luscasos/PI3-carro/Hardware/3d placa.png

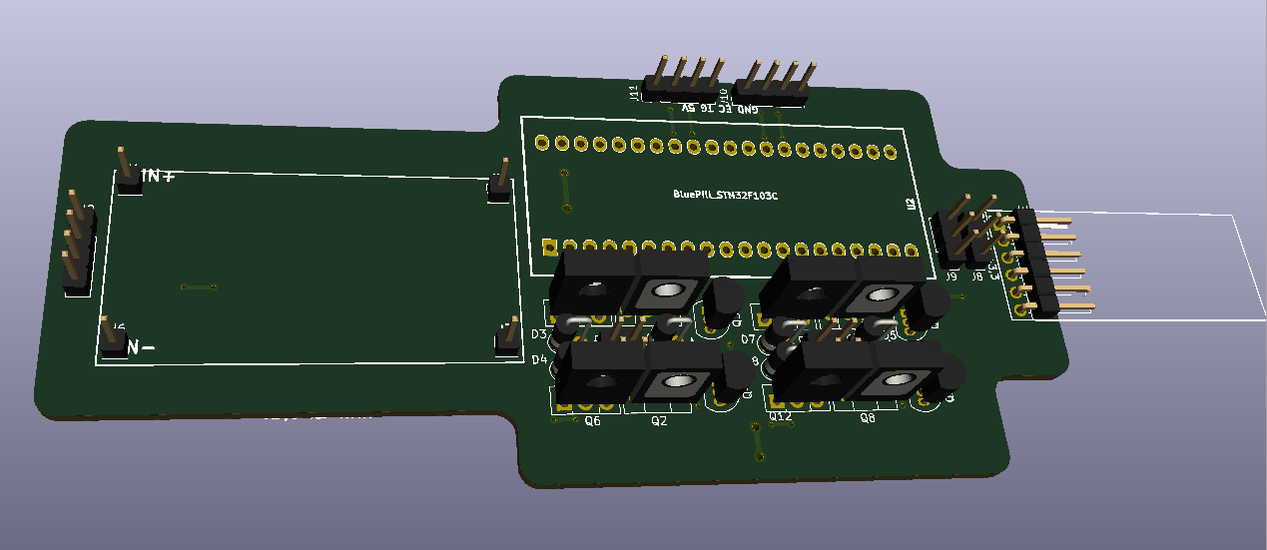
Hardware/3d placa.png
