luscasos/PI3-carro/README.md

# Projeto integrador III

carro final

## Informações gerais
Desenvolvido no escopo da disciplina de Projeto Integrador III, do curso de Eng. Eletrônica do IFSC campus Florianópolis no primeiro semestre de 2019, esse projeto tem como objetivo utilizar os conhecimentos obtidos ao decorrer do curso, implementando um carro controlado via aplicativo Android.

## Tabela inicial de requisitos
* Controle via aplicativo Android
* Comunicação via bluetooth
* Sensoriamento de velocidade e transmissão para o app 
* Controle de velocidade via aplicativo 
* Controle da bateria

## Tecnologias
* Parte mecânica do carro, disponível em https://s.click.aliexpress.com/e/bD9t0zL3
* Celular Android
* Microcontrolador STM32
* Bateria de íon de lítio
	
# Hardware

* ## Acionamento dos motores

Para acionar os motores foram levadas em conta os requisitos de projeto, que nesse quesito são:
* Controle de direção do movimento
* Controle de velocidade

Com relação ao controle de direção foi escolhido o sistema de ponte H, na qual é possível alterar o sentido da corrente invertendo as tensões nos terminais L e R, a forma escolhida de acionamento dos motores foi conectar em paralelo os motores do mesmo lado do carro, necessitando de duas pontes para o controle dos quatro motores 

Ponte H

O primeiro filtro para escolha do circuito foi a disponibilidade de componentes no almoxarifado, que para ponte H se limitava a:
* L293B
Corrente máxima 1A por canal

* L6203		
Corrente máxima 5A

* SN754410NE
Com uso restrito para manutenção

* Circuito discreto com BD140 e BD139
Corrente máxima 1,5A
 
### Escolha
Como nesse projeto vamos trabalhar com quatro motores, dois por canal, e sendo eles de tensão nominal de 3 - 6V e corrente nominal de 300mA todos os circuitos cumprem o requisito de potência mínima, O L6203 foi descartado por ser uma ponte H de potência, ficando superdimensionado e encarecendo o projeto, ficando a escolha entre o circuito discreto e o L2931B no quesito eficiência energética, afinal, se trata de um sistema embarcado, e por isso necessita de um cuidado maior com a eficiência
Montado os dois circuitos de acionamento alimentados em 5V foi obtido uma tensão de 3,08V com o integrado e 4,6V no circuito discreto, uma diferença de 35% no consumo do circuito, sendo escolhido o circuito discreto.  

Circuito final de alimentação dos motores, com queda de 0,4V de tensão na carga em relação a VCC e corrente de polarização externa de 640pA, não exigindo muita corrente do microcontrolador.
Ponte H

* ## Microcontrolador
Para controle do carro foi utilizado o stm32f103, na sua versão de desenvolvimento conhecido como "blue pill", que possui um cortex M3 com um clock de 72MHz e que conta com 20kb de RAM, quatro Timers, dois ADCs entre outros, que serão usados na aplicação.

STM

* ## Comunicação
Como a comunicação entre celular e carro é feita via bluetooth foi escolhido o modulo HC-05, que trata todo o protocolo de comunicação e se comunica com microcontrolador via UART, sendo de fácil uso e configuração.
HC-05

* ## Aferição de velocidade 
Para medir a velocidade foi escolhido um encoder com sensor óptico, que consiste em um diodo emissor de luz e um receptor, separados por uma roda perfurada, que quando a roda esta em movimento gera um sinal com frequência proporcional a velocidade da roda.

encoder2
encoder

* ## Baterias 
Para alimentar o carro foram escolhidas duas baterias de LIPO, de 3,7V e 1200mAh, conectadas em série, o que resulta em 7,4V de tensão. 

Bateria
* ## Regulador de tensão
Como o conjunto de baterias tem como tensão 7,4V na saída, é necessário baixar a tensão para níveis aceitáveis para o microcontrolador e modulo bluetooth, no caso foi usado um regulador ajustável Step-up-down, por questão de disponibilidade, mesmo esse sendo superdimensionado para a aplicação em questão, já que suporta correntes de até 5A e nesse caso não passa de 200mA.

Regulador

* ## Medição da tensão das baterias
Como regra geral, não se pode descarregar uma bateria abaixo de uma certa tensão, com as usadas nesse projeto não é diferente, não sendo recomendado baixar a tensão da marca dos 3V, como o sistema possui duas baterias é necessário medir a tensão delas individualmente. O conversor analógico digital do microcontrolador tem como tensão base 3V, então é preciso baixar as tensões para menos de 3V, o circuito usado para isso é o diferencial com ampop, que pode dar um ganho menor que 1, sem usar tensão negativa. O Ampop escolhido foi o LM324, com ganho de 1/3 para a tensão superior (bateria 1 em serie com a bateria 2), e de 2/3 para a tensão media (bateria 1). 
diferencial

* ## Placa de circuito
Com todos os requisitos de Hardware definidos foi desenvolvido o esquemático e placa do projeto
esquematico
Placa 3d

carro visto de cima

A placa de circuito impresso foi projetada para que o circuito de comunicação bluetooth ficasse longe do principal foco do ruído do circuito, que são os motores, contudo ainda foi deixado o uC ao lado dos motores e das pontes H, uma implementação mais correta seria distanciar esses dois componentes geradores de ruído, juntamente com o regulador de tensão. e acoplar o sensor de velocidade de outra maneira, que não por cabos longos como foi projetado, essas e outras correções foram feitas em outra placa a ser utilizada em disciplinas ligadas a programação de microcontroladores.

O carro também foi objeto de estudo por uma dupla de colegas dentro da disciplina de compatibilidade eletromagnética, estando todos dados disponíveis no link https://github.com/lsmanoel/CEM_3

# Software do microcontrolador

* ## Controle de velocidade
O controle da velocidade vai ser feito por meio da técnica de modulação PWM, via microcontrolador atuando sobre a ponte H.
Como o circuito de ponte H escolhido não pode em hipótese alguma ter o os dois transistores de atuação polarizados ao mesmo tempo, optou-se por utilizar o PWM no modo normal e no modo inverso, de forma a construir um sistema redundante nesse sentido, se houver uma falha no software mesmo assim não haverá um problema critico na ponte H.

PWM

A implementação foi feita via dois Timers, com frequência fixa em 1kHz, em ambos usando o canal 1 e o canal 1N, trabalhando sempre com pelo menos um deles desligado. Sabendo que a velocidade vai ser transmitida pelo aplicativo em 1Byte, com 256 possibilidades, de -128 a 127. Sendo assim o valor 127 corresponde a 100% da velocidade para frente, enquanto -128 corresponde a 100% da velocidade na ré.
Como os motores possuem uma inércia, não será qualquer valor de tensão que dará partida no carro, sabendo disso pode-se dar um offset no valor do pwm, nesse caso escolhi cerca de 45% de razão cíclica, o que é suficiente para dar partida nos motores.

* ## Medição das baterias
A medição das baterias foi feita por um ADC, utilizando dois canais, um para a tensão total (bateria 1 em serie com a bateria 2) e um canal para a tensão da bateria 1, lembrando que estas tensões já receberam um ganho de 1/3 (tensão total) e 2/3 (tensão da bateria 1). então levando em consideração esse ganho e os dois canais pode-se medir individualmente a tensão de cada bateria para que o sistema possa desligar os motores e avisar o usuário que a carga das baterias esta crítica.

* ## Medição da velocidade
A velocidade é calculada com base na variação de um sensor ótico e como a roda perfurada possui 20 furos, para cada uma volta da roda são medidas 20 alternâncias no sensor, com isso e o diâmetro da roda é possível saber a distância percorrida por pulso. Além da componente de distância é necessário saber o tempo entre medições, nesse caso foi utilizada um tempo de 100ms.

equacao
onde n é o número de pulsos por período

Também foi implementado um [filtro media movel](http://borgescorporation.blogspot.com/2013/05/filtro-de-media-movel.html
) de 16 fatores afim de filtrar ruídos indesejados

* ## Comunicação
A comunicação entre o microcontrolador e o modulo bluetooth HC-05 é feita via UART que possui hardware dedicado na maioria dos microcontroladores, então a implementação consiste basicamente em criar um pacote de dados para envio de todos os parâmetros juntos no formato "00;00;00;00". O tratamento de dados recebidos pelo uC é feito por interrupção, reconhecendo o final do dado, que é "\r\n" e separando os demais bits, que são as coordenadas Y e Z.

# Controle de Direção e sentido
Tanto o controle de direção quanto o de sentido serão feitas via aplicação em Android e transmitidas por bluetooth para o microcontrolador embarcado no carro, o controle de sentido será feito via dois botões, um para ré e outro para frente, não pressionado nenhum o carro fica parado, com a possibilidade de fixar uma velocidade constante. A direção será feita via medição dos acelerômetros do celular, que fara o celular nesse caso atuar como um volante.

# Aplicativo Android

O aplicativo conta com as seguintes funcionalidades:

* Botão de conexão bluetooth no canto superior direito, que é responsável por ligar o bluetooth caso o mesmo esteja desligado, buscar a lista de dispositivos pareados e conectar no mesmo, iniciando a comunicação.
* Botão Start/Stop responsável por interromper ou não o fluxo de dados de aceleração do celular para o dispositivo pareado.
* Texto central com os valores de aceleração individual dos eixos.
* Texto na lateral esquerda com os valores de bateria e velocidade enviados pelo dispositivo conectado. 

Aplicativo

<p>
A estrutura dos dados de aceleração é a seguinte: 
<pre><code>byte dado[]=new byte[4];
        dado[0]=y;
        dado[1]=z;
        dado[2]='\r';
        dado[3]='\n';
        connectedThread.write(dado);
  </code></pre>
</p>

Já a estrutura dos dados recebidos tem que estar no seguinte formato: "00;00;00;00", sendo que o aplicativo insere uma virgula entre cada um dos valores.
