luscasos/PI3-carro/Hardware/esquematico completo.png

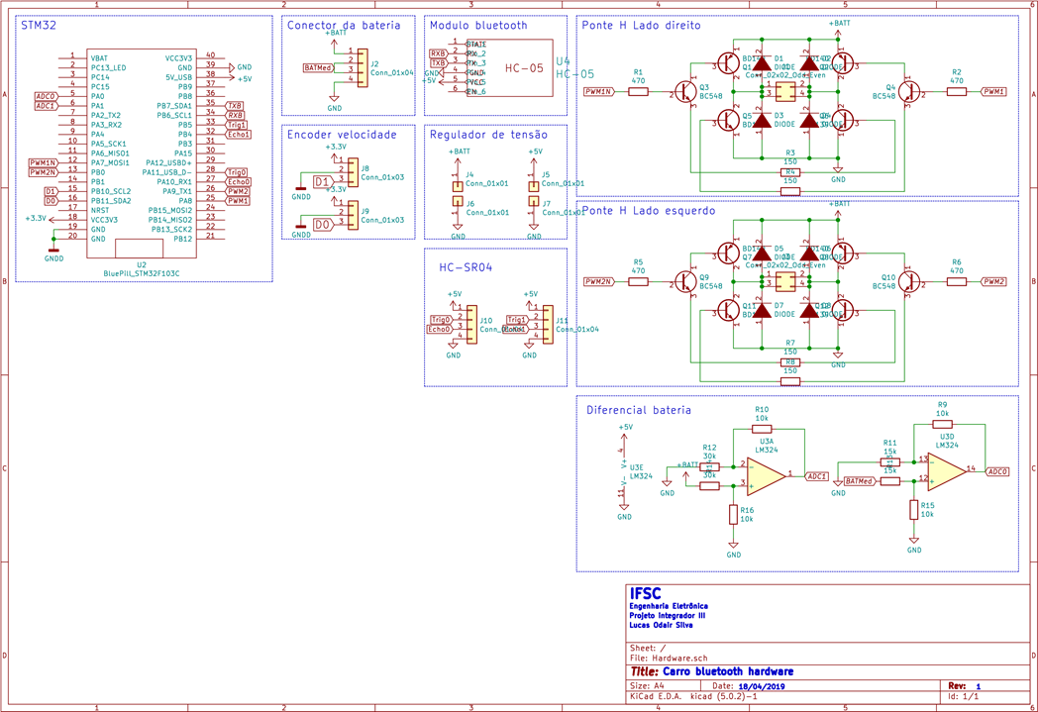
Hardware/esquematico completo.png
