luscasos/PI3-carro/Hardware/esquematico completo.pdf

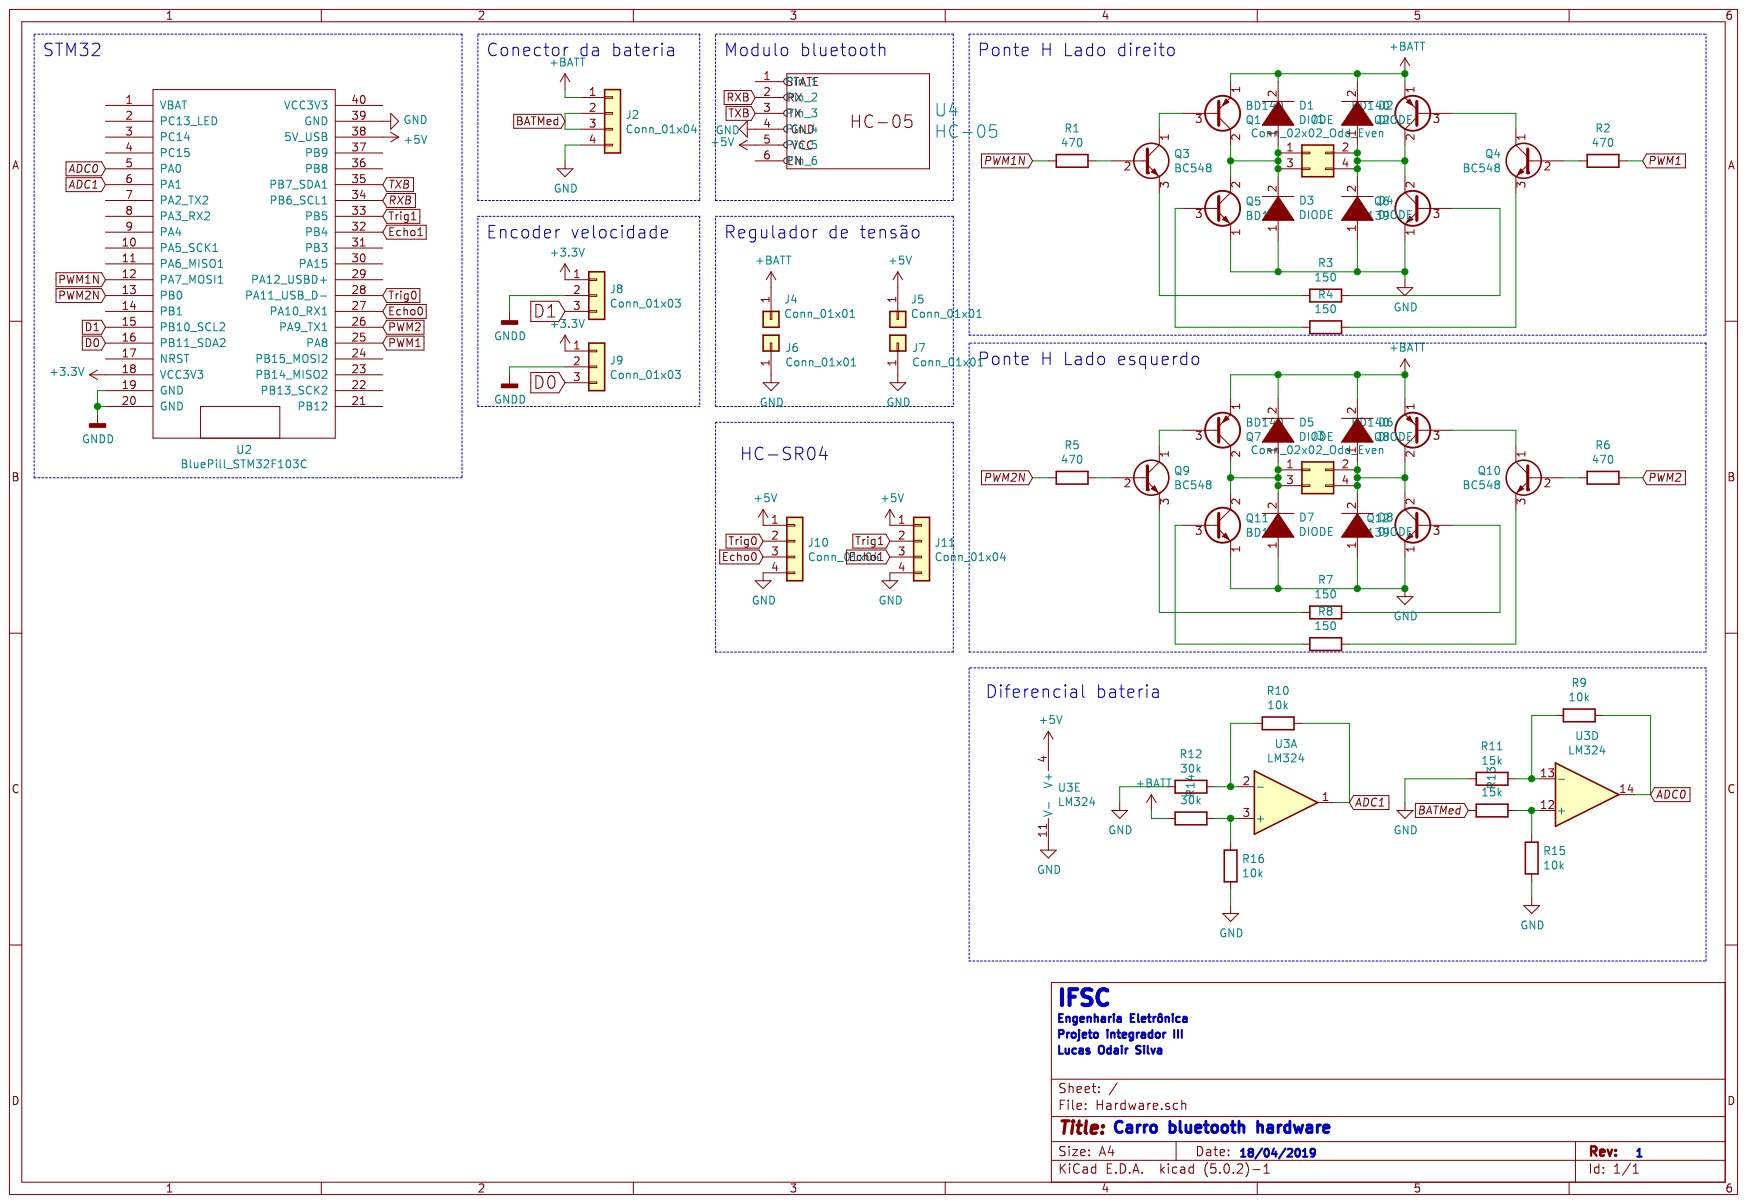
[picture p3: page 1]
