luscasos/PI3-carro/Hardware/Hardware.kicad_pcb

## KiCad design Hardware/Hardware.kicad_pcb (2019-05-08)

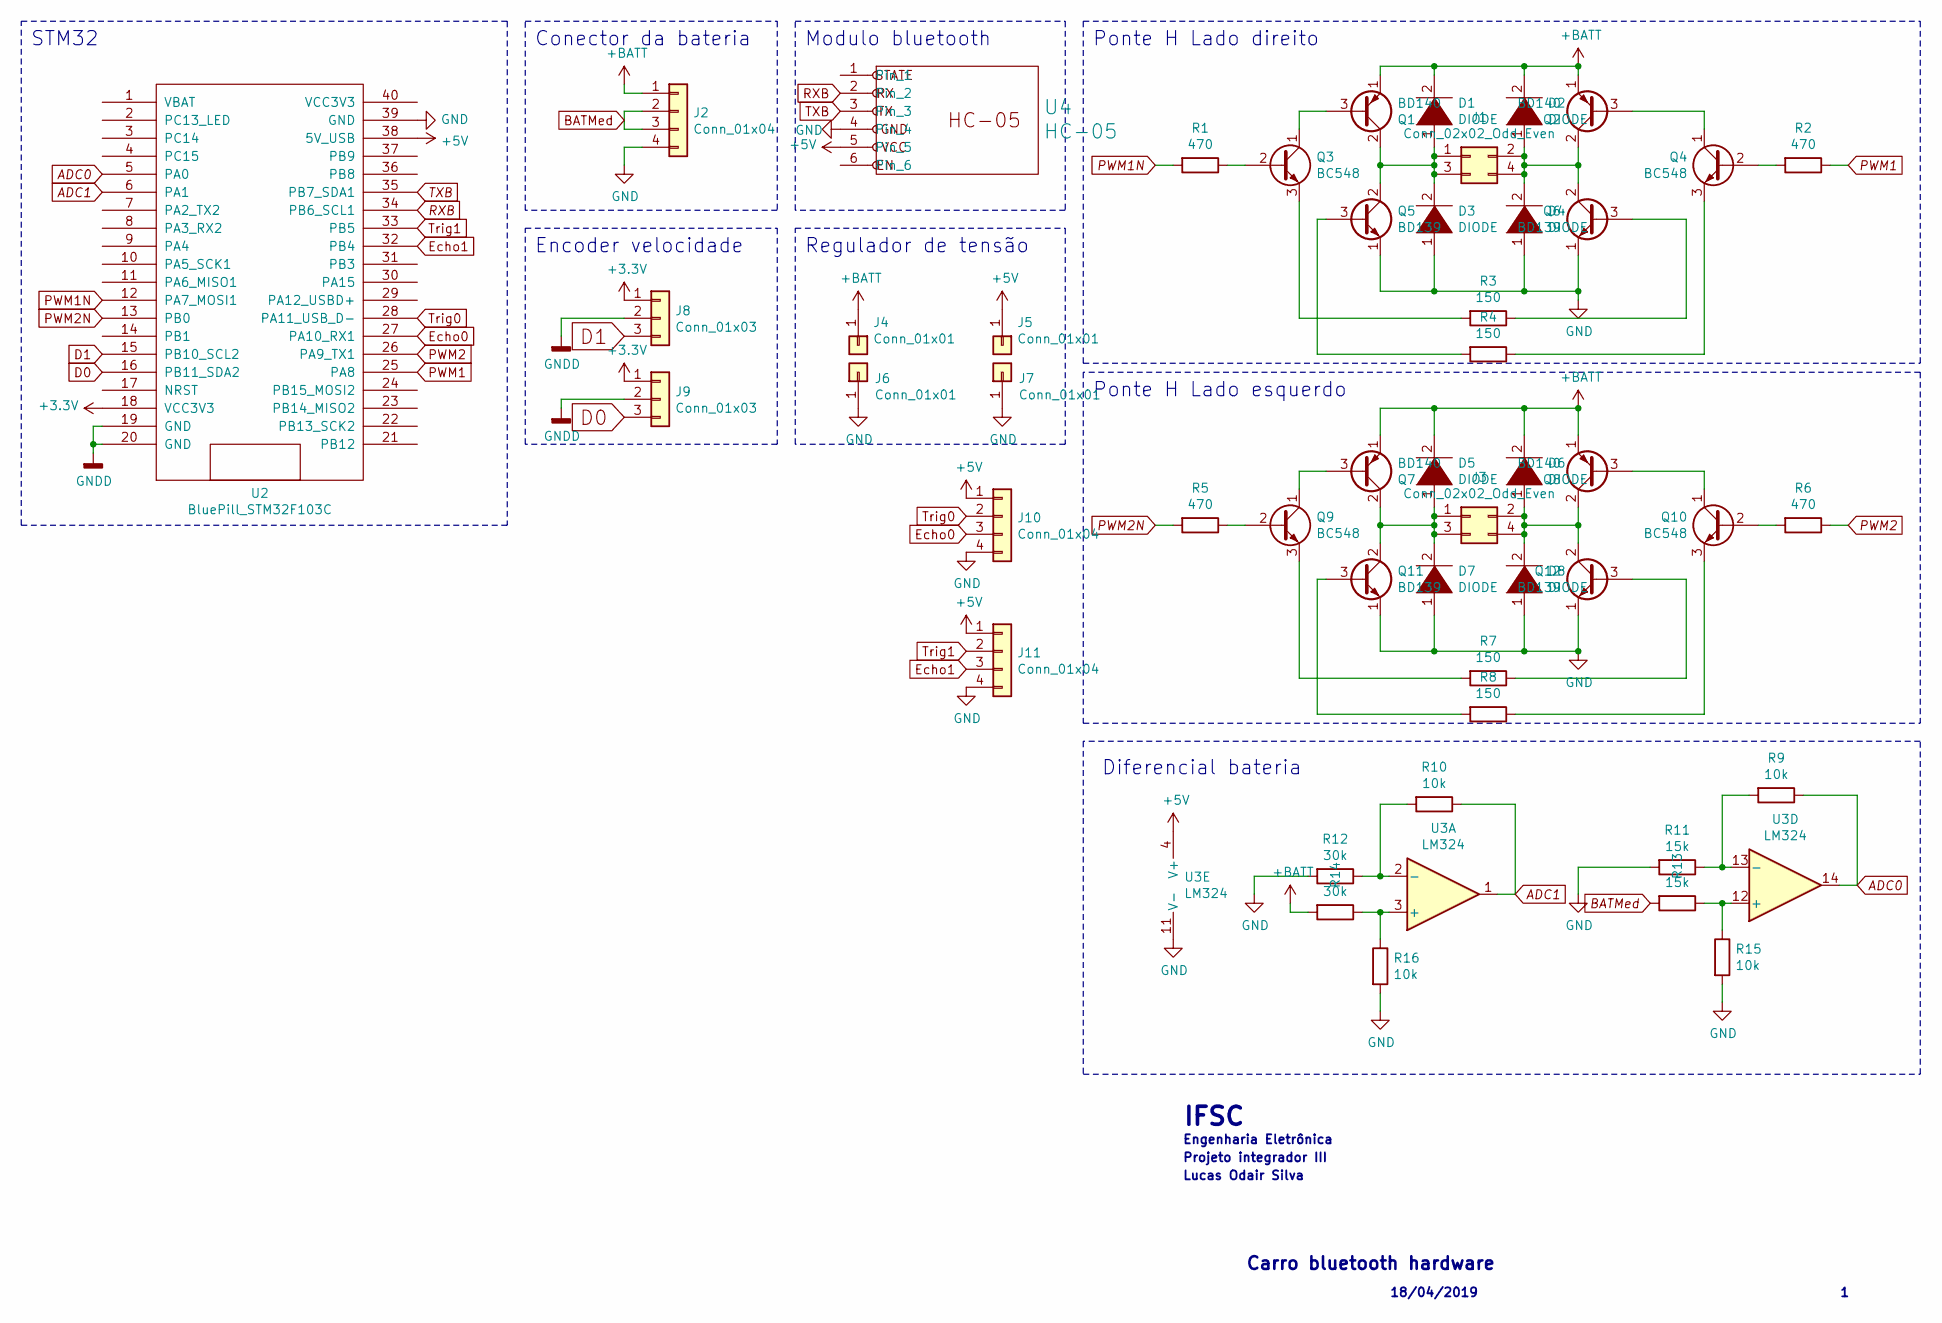
[picture p4: schematic Hardware.sch]

Parts:
D1, D2, D3, D4, D5, D6, D7, D8: DIODE; D_A-405_P2.54mm_Vertical_AnodeUp
J1, J3: Conn_02x02_Odd_Even; PinHeader_2x02_P2.54mm_Vertical
J2, J10, J11: Conn_01x04; PinHeader_1x04_P2.54mm_Vertical
J4, J5, J6, J7: Conn_01x01; PinHeader_1x01_P2.54mm_Vertical
J8, J9: Conn_01x03; PinHeader_1x03_P2.54mm_Vertical
Q1, Q2, Q7, Q8: BD140; TO-126-3_Vertical
Q3, Q4, Q9, Q10: BC548; TO-92_Inline
Q5, Q6, Q11, Q12: BD139; TO-126-3_Vertical
R1, R2, R5, R6: 470; R_0805_2012Metric
R3, R4, R7, R8: 150; R_0805_2012Metric
R9, R10, R15, R16: 10k; R_0805_2012Metric
R11, R13: 15k; R_0805_2012Metric
R12, R14: 30k; R_0805_2012Metric
U2: BluePill_STM32F103C
U3: LM324; SOIC-14_3.9x8.7mm_P1.27mm
U4: HC-05; PinHeader_1x06_P2.54mm_Horizontal

Connections:
+3V3: J8.1, J9.1, U2.18 (VCC3V3)
+5V: J5.1, J10.1, J11.1, U2.38 (5V_USB), U3.4 (V+), U4.5
+BATT: D1.2 (A), D2.2 (A), D5.2 (A), D6.2 (A), J2.1, J4.1, Q1.1 (E), Q2.1 (E), Q7.1 (E), Q8.1 (E), R14.2
ADC0: R9.1, U2.5 (PA0), U3.14
ADC1: R10.1, U2.6 (PA1), U3.1
BATMed: J2.2, J2.3, R13.2
D0: J9.3, U2.16 (PB11_SDA2)
D1: J8.3, U2.15 (PB10_SCL2)
Echo0: J10.3, U2.27 (PA10_RX1)
Echo1: J11.3, U2.32 (PB4)
GND: D3.1 (K), D4.1 (K), D7.1 (K), D8.1 (K), J2.4, J6.1, J7.1, J10.4, J11.4, Q5.1 (E), Q6.1 (E), Q11.1 (E), Q12.1 (E), R11.2, R12.2, R15.2, R16.2, U2.39 (GND), U3.11 (V-), U4.4
GNDD: J8.2, J9.2, U2.19 (GND), U2.20 (GND)
unnamed: D1.1 (K), D3.2 (A), J1.1, J1.3, Q1.2 (C), Q5.2 (C)
unnamed: D2.1 (K), D4.2 (A), J1.2, J1.4, Q2.2 (C), Q6.2 (C)
unnamed: D5.1 (K), D7.2 (A), J3.1, J3.3, Q7.2 (C), Q11.2 (C)
unnamed: D6.1 (K), D8.2 (A), J3.2, J3.4, Q8.2 (C), Q12.2 (C)
unnamed: Q1.3 (B), Q3.1 (C)
unnamed: Q2.3 (B), Q4.1 (C)
unnamed: Q3.2 (B), R1.1
unnamed: Q3.3 (E), R3.2
unnamed: Q4.2 (B), R2.2
unnamed: Q4.3 (E), R4.1
unnamed: Q5.3 (B), R4.2
unnamed: Q6.3 (B), R3.1
unnamed: Q7.3 (B), Q9.1 (C)
unnamed: Q9.2 (B), R5.1
unnamed: Q9.3 (E), R7.2
unnamed: Q8.3 (B), Q10.1 (C)
unnamed: Q10.2 (B), R6.2
unnamed: Q10.3 (E), R8.1
unnamed: Q11.3 (B), R8.2
unnamed: Q12.3 (B), R7.1
unnamed: R10.2, R12.1, U3.2 (-)
unnamed: R9.2, R11.1, U3.13 (-)
unnamed: R13.1, R15.1, U3.12 (+)
unnamed: R14.1, R16.1, U3.3 (+)
PWM1: R2.1, U2.25 (PA8)
PWM1N: R1.2, U2.12 (PA7_MOSI1)
PWM2: R6.1, U2.26 (PA9_TX1)
PWM2N: R5.2, U2.13 (PB0)
RXB: U2.34 (PB6_SCL1), U4.2
TXB: U2.35 (PB7_SDA1), U4.3
Trig0: J10.2, U2.28 (PA11_USB_D-)
Trig1: J11.2, U2.33 (PB5)

Notes on the sheet:
Carro bluetooth hardware
18/04/2019
IFSC
Projeto integrador III
Lucas Odair Silva
Engenharia Eletrônica
Ponte H Lado direito
Ponte H Lado esquerdo
Diferencial bateria
Modulo bluetooth
Conector da bateria
Regulador de tensão
STM32
Encoder velocidade

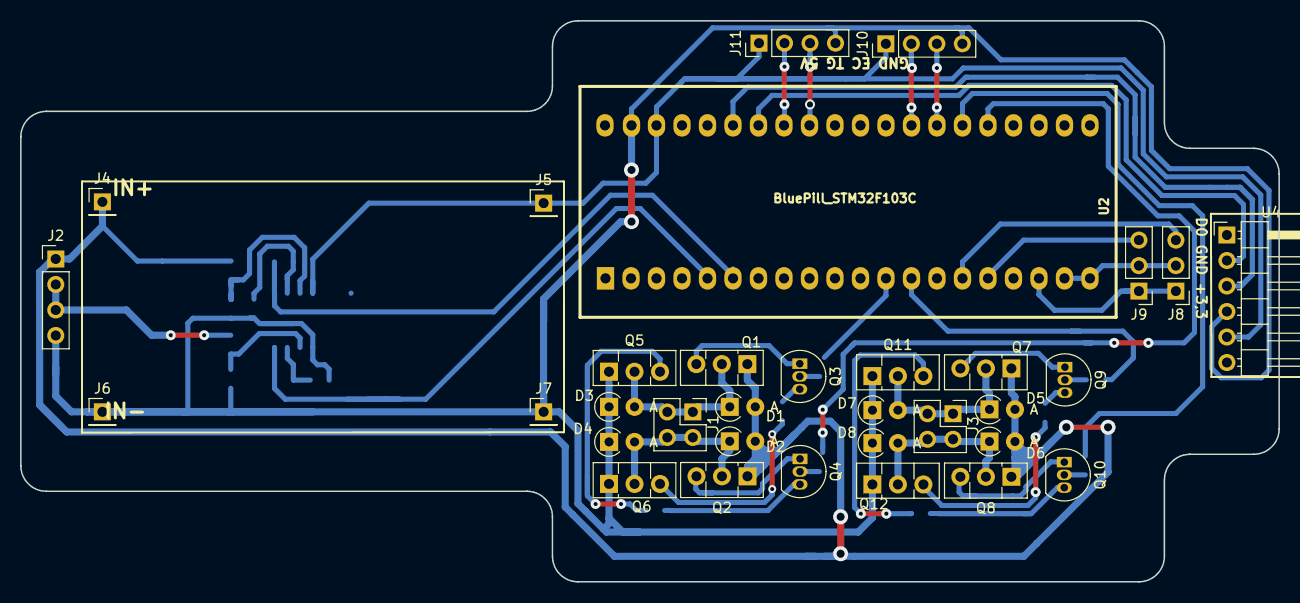
[picture p5: board Hardware.kicad_pcb from above]

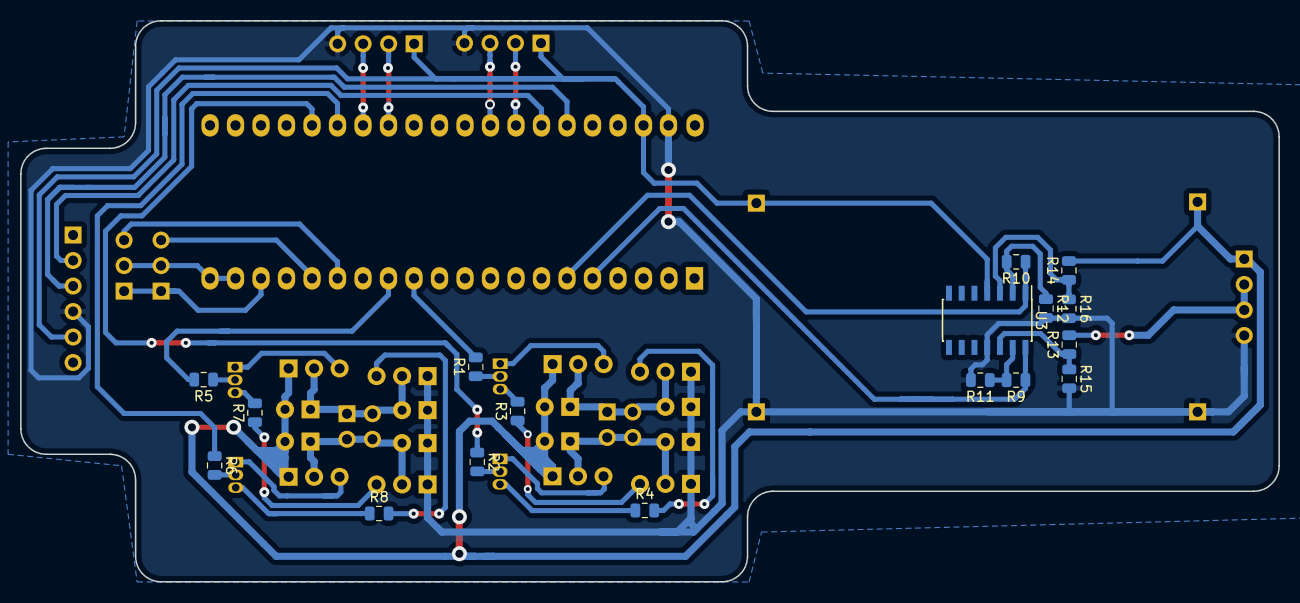
[picture p6: board Hardware.kicad_pcb from below]

Board: 2 copper layers, 125.3 x 55.9 mm, 50 parts (17 on the bottom side), 44 nets.
