luscasos/PI3-carro/PI3 carro ucontrolador/Src/main.c

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

/* Includes ------------------------------------------------------------------*/
#include "main.h"

/* USER CODE BEGIN Includes */
//#include "i2c-lcd.h"
//#include <stdio.h>
#include <stdlib.h>
#include <string.h>

/* USER CODE END Includes */

/* USER CODE BEGIN PTD */

#define ConstanteDeVelocidade 23//23,67 	// (distanciaPorPulso/tempo)*0,036 para km/h 1.052433539/100m

/* USER CODE END PTD */

ADC_HandleTypeDef hadc1;

TIM_HandleTypeDef htim1;
TIM_HandleTypeDef htim2;

UART_HandleTypeDef huart1;

void SystemClock_Config(void);
static void MX_GPIO_Init(void);
static void MX_TIM1_Init(void);
static void MX_USART1_UART_Init(void);
static void MX_ADC1_Init(void);
static void MX_TIM2_Init(void);
/* USER CODE BEGIN PFP */

void SetDirecao();
int SomaMovel(int novaAquisicao,int valorAtual,int *it,int*buf);

/* USER CODE END PFP */

/* USER CODE BEGIN 0 */

volatile uint8_t z=127;
volatile uint8_t y=127;
volatile int toggleLeftEncoder=0;
volatile int toggleRightEncoder=0;
volatile int velocidadeR=0;
volatile int velocidadeL=0;
int BufferR[16]={0};
int k=0;
int BufferL[16]={0};
int m=0;
char txBuffer[32]={0};
char tx2Buffer[20]={0};
char rxBuffer[24];

volatile int adc_value_1;
volatile int adc_value_2;




/* USER CODE END 0 */

/**
  * @brief  The application entry point.
  * @retval int
  */
int main(void)
{
  /* MCU Configuration--------------------------------------------------------*/

  /* Reset of all peripherals, Initializes the Flash interface and the Systick. */
  HAL_Init();

  /* Configure the system clock */
  SystemClock_Config();

  /* Initialize all configured peripherals */
  MX_GPIO_Init();
  MX_TIM1_Init();
  MX_USART1_UART_Init();
  MX_ADC1_Init();
  MX_TIM2_Init();
  /* USER CODE BEGIN 2 */
  HAL_TIM_Base_Start_IT(&htim1);
  HAL_TIM_Base_Start_IT(&htim2);
  HAL_ADC_Init(&hadc1);


//  HAL_TIM_PWM_Start(&htim1,TIM_CHANNEL_1);
//  HAL_TIMEx_PWMN_Start(&htim1,TIM_CHANNEL_1);
//  HAL_TIM_PWM_Start(&htim1,TIM_CHANNEL_2);
//  HAL_TIMEx_PWMN_Start(&htim1,TIM_CHANNEL_2);
  //lcd_init();

	HAL_UART_Receive_IT(&huart1,(uint8_t *)rxBuffer,4);
	//HAL_ADC_Start(&hadc1);
  /* USER CODE END 2 */

  /* Infinite loop */
  /* USER CODE BEGIN WHILE */
  while (1)
  {

	  //ReadAcelerometro();
	  HAL_ADC_Start(&hadc1);
	  HAL_ADC_PollForConversion(&hadc1,100);
	  adc_value_1 = HAL_ADC_GetValue(&hadc1);
	  HAL_ADC_PollForConversion(&hadc1,100);
	  adc_value_2 = HAL_ADC_GetValue(&hadc1);
	  HAL_ADC_Stop(&hadc1);


	  SetDirecao();

    /* USER CODE END WHILE */

    /* USER CODE BEGIN 3 */
  }
  /* USER CODE END 3 */
}

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
/* USER CODE BEGIN 4 */

void SetDirecao(){
		int pwm1=0;
		int pwm2=0;
		if(z>140){	// frente
				pwm1=(z-127+(y-127))*24+4100;
				if(pwm1>8000){
					pwm1=8000;
				}
					pwm2=(z-127-(y-127))*24+4100;
				if(pwm2>8000)
					pwm2=8000;

			__HAL_TIM_SET_COMPARE(&htim1, TIM_CHANNEL_1,pwm1);
			__HAL_TIM_SET_COMPARE(&htim1, TIM_CHANNEL_2,pwm2);
			HAL_TIMEx_PWMN_Stop(&htim1,TIM_CHANNEL_1);
			HAL_TIMEx_PWMN_Stop(&htim1,TIM_CHANNEL_2);
			HAL_TIM_PWM_Start(&htim1,TIM_CHANNEL_1);
			HAL_TIM_PWM_Start(&htim1,TIM_CHANNEL_2);
		}
		else if(z<114){	// ré
			pwm1=(-z+127+(y-127))*24+4100;
			if(pwm1>8000)
				pwm1=8000;
			pwm2=(-z+127-(y-127))*24+4100;
			if(pwm2>8000)
				pwm2=8000;
			__HAL_TIM_SET_COMPARE(&htim1, TIM_CHANNEL_1,pwm1);
			__HAL_TIM_SET_COMPARE(&htim1, TIM_CHANNEL_2,pwm2);
			HAL_TIM_PWM_Stop(&htim1,TIM_CHANNEL_1);
			HAL_TIM_PWM_Stop(&htim1,TIM_CHANNEL_2);
			HAL_TIMEx_PWMN_Start(&htim1, TIM_CHANNEL_1);
			HAL_TIMEx_PWMN_Start(&htim1, TIM_CHANNEL_2);
		}else{ // para
			HAL_TIM_PWM_Stop(&htim1,TIM_CHANNEL_1);
			HAL_TIM_PWM_Stop(&htim1,TIM_CHANNEL_2);
			HAL_TIMEx_PWMN_Stop(&htim1,TIM_CHANNEL_1);
			HAL_TIMEx_PWMN_Stop(&htim1,TIM_CHANNEL_2);
		}

	}


void HAL_UART_RxCpltCallback(UART_HandleTypeDef *huart){
	if(rxBuffer[2]=='\r' && rxBuffer[3]=='\n'){
		y=rxBuffer[0];
		z=rxBuffer[1];
	}
	HAL_UART_Receive_IT(&huart1,(uint8_t *)rxBuffer,4);
}

//void HAL_UART_TxHalfCpltCallback(UART_HandleTypeDef *huart){
//}

 void HAL_GPIO_EXTI_Callback(uint16_t GPIO_Pin)
{
	 if(GPIO_Pin==LeftEncoder_Pin){
	 		 toggleLeftEncoder+=1;
	 }else if(GPIO_Pin==RightEncoder_Pin){
	 		 toggleRightEncoder+=1;
	 }

}

 int nAquisicoesLeft=0;
 int nAquisicoesRight=0;

 void TIM2_IRQHandler(void)
 {
	 nAquisicoesRight=SomaMovel(toggleRightEncoder, nAquisicoesRight,&k,BufferR);
	 nAquisicoesLeft=SomaMovel(toggleLeftEncoder, nAquisicoesLeft,&m,BufferL);
	 toggleRightEncoder=0;
	 toggleLeftEncoder=0;


		//(velocidadeL,(char*)buf,10);
		//HAL_UART_Transmit_IT(&huart1,,4);
	 snprintf(txBuffer,32,"%d;%d;%d;%d\n",ConstanteDeVelocidade*nAquisicoesLeft/200,
			 ConstanteDeVelocidade*nAquisicoesRight/200,(int)(10*adc_value_1*0.00122),(int)(10*adc_value_2*0.00273-10*adc_value_1*0.00122));

	HAL_UART_Transmit_IT(&huart1,(uint8_t *)txBuffer,strlen(txBuffer));



   HAL_TIM_IRQHandler(&htim2);
   //HAL_ADC_Start_IT(&hadc1); // Re-Start ADC1 under Interrupt


 }


 int SomaMovel(int novaAquisicao,int valorAtual,int *it,int*buf){
 	valorAtual=novaAquisicao+valorAtual-buf[*it];
 	buf[*it]=novaAquisicao;
  	*it=*it+1;
    *it=*it&0xF;
  	return valorAtual;
  }



/* USER CODE END 4 */
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
