luscasos/PI3-carro/PI3 carro ucontrolador/PI3 carro ucontrolador.ioc

Mcu.UserName=STM32F103C8Tx
PA0-WKUP.Signal=ADCx_IN0
PA1.Signal=ADCx_IN1
PA13.Signal=SYS_JTMS-SWDIO
PA14.Signal=SYS_JTCK-SWCLK
PA7.Signal=TIM1_CH1N
PA8.Signal=S_TIM1_CH1
PA9.Signal=S_TIM1_CH2
PB0.Signal=TIM1_CH2N
PB10.GPIO_Label=LeftEncoder
PB10.Signal=GPXTI10
PB11.GPIO_Label=RightEncoder
PB11.Signal=GPXTI11
PB6.Signal=USART1_TX
PB7.Signal=USART1_RX
