luscasos/PI3-carro/PI3 carro ucontrolador/Inc/main.h

#define LeftEncoder_Pin GPIO_PIN_10
#define LeftEncoder_GPIO_Port GPIOB
#define LeftEncoder_EXTI_IRQn EXTI15_10_IRQn
#define RightEncoder_Pin GPIO_PIN_11
#define RightEncoder_GPIO_Port GPIOB
#define RightEncoder_EXTI_IRQn EXTI15_10_IRQn
